TasS-RV/fpcb-glove-design/Forearm pad - proto cutout paper.jpg

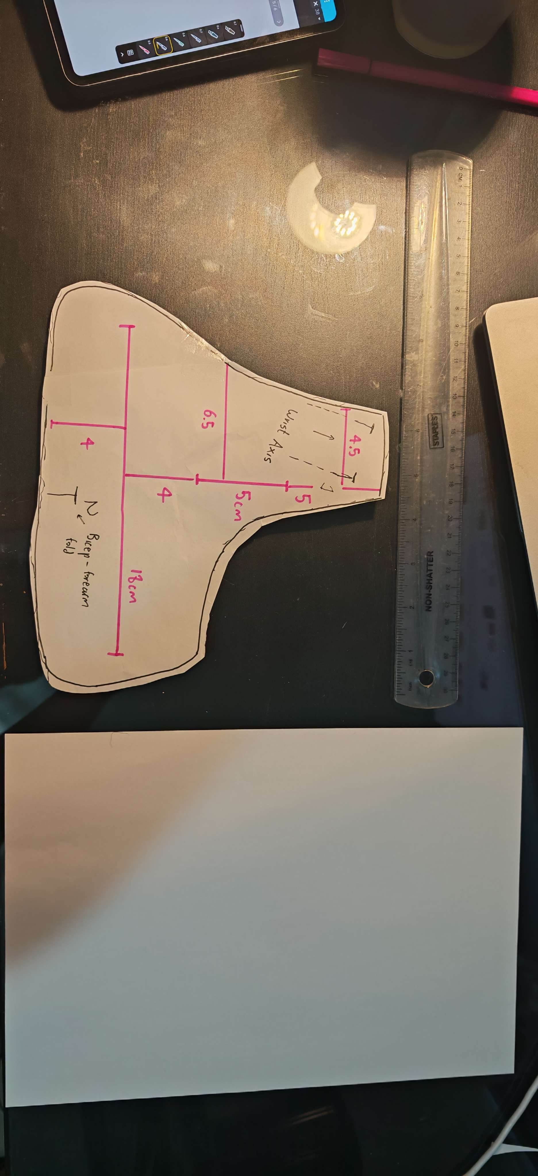
Forearm pad - proto cutout paper.jpg
