TasS-RV/fpcb-glove-design/forearm paper.jpg

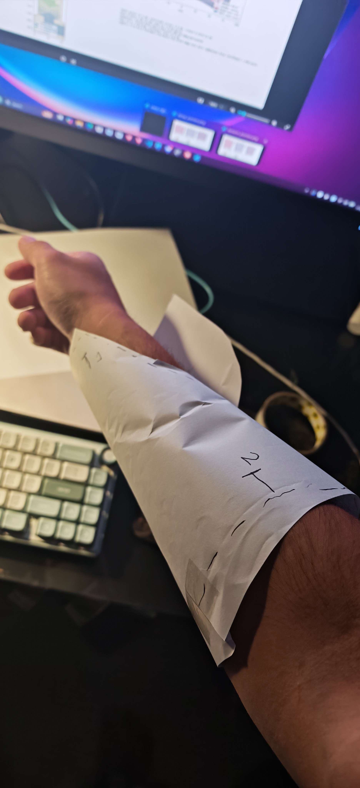
forearm paper.jpg
