TasS-RV/fpcb-glove-design/body_pads/out/bicep/pinout_Back.csv

J1 pin | channel | electrode_index | electrode_pos_mm | lane | via_row
5 | ROW01 | 1 | -60.30 | 11 | B
6 | ROW02 | 2 | -47.80 | 10 | A
7 | ROW03 | 3 | -35.30 | 9 | B
8 | ROW04 | 4 | -22.80 | 8 | A
9 | ROW05 | 5 | -10.30 | 7 | B
10 | ROW06 | 6 | 2.20 | 6 | A
11 | ROW07 | 7 | 14.70 | 5 | B
12 | ROW08 | 8 | 27.20 | 4 | A
13 | ROW09 | 9 | 39.70 | 3 | B
14 | ROW10 | 10 | 52.20 | 2 | A
15 | ROW11 | 11 | 64.70 | 1 | B
16 | ROW12 | 12 | 77.20 | 0 | A
1 | NC
2 | NC
3 | NC
4 | NC
