TasS-RV/fpcb-glove-design/body_pads/out/forearm/pinout_Back.csv

J1 pin | channel | electrode_index | electrode_pos_mm | lane | via_row
3 | ROW00 | 0 | -192.73 | 13 | B
4 | ROW01 | 1 | -179.23 | 12 | A
5 | ROW02 | 2 | -165.73 | 11 | B
6 | ROW03 | 3 | -152.23 | 10 | A
7 | ROW04 | 4 | -138.73 | 9 | B
8 | ROW05 | 5 | -125.23 | 8 | A
9 | ROW06 | 6 | -111.73 | 7 | B
10 | ROW07 | 7 | -98.23 | 6 | A
11 | ROW08 | 8 | -84.73 | 5 | B
12 | ROW09 | 9 | -71.23 | 4 | A
13 | ROW10 | 10 | -57.73 | 3 | B
14 | ROW11 | 11 | -44.23 | 2 | A
15 | ROW12 | 12 | -30.73 | 1 | B
16 | ROW13 | 13 | -17.23 | 0 | A
1 | NC
2 | NC
