TasS-RV/fpcb-glove-design/body_pads/out/forearm/pinout_Front.csv

J1 pin | channel | electrode_index | electrode_pos_mm | lane | via_row
1 | COL00 | 0 | -98.25 | 6 | A
2 | COL01 | 1 | -84.75 | 5 | B
3 | COL02 | 2 | -71.25 | 4 | A
4 | COL03 | 3 | -57.75 | 3 | B
5 | COL04 | 4 | -44.25 | 2 | A
6 | COL05 | 5 | -30.75 | 1 | B
7 | COL06 | 6 | -17.25 | 0 | A
8 | COL07 | 7 | -3.75 | 0 | B
9 | COL08 | 8 | 9.75 | 1 | A
10 | COL09 | 9 | 23.25 | 2 | B
11 | COL10 | 10 | 36.75 | 3 | A
12 | COL11 | 11 | 50.25 | 4 | B
13 | COL12 | 12 | 63.75 | 5 | A
14 | COL13 | 13 | 77.25 | 6 | B
15 | COL14 | 14 | 90.75 | 7 | A
16 | COL15 | 15 | 104.25 | 8 | B
