TasS-RV/fpcb-glove-design/body_pads/out/bicep/pinout_Front.csv

J1 pin | channel | electrode_index | electrode_pos_mm | lane | via_row
1 | COL00 | 0 | -79.25 | 5 | A
2 | COL01 | 1 | -66.75 | 4 | B
3 | COL02 | 2 | -54.25 | 3 | A
4 | COL03 | 3 | -41.75 | 2 | B
5 | COL04 | 4 | -29.25 | 1 | A
6 | COL05 | 5 | -16.75 | 0 | B
7 | COL06 | 6 | -4.25 | 0 | A
8 | COL07 | 7 | 8.25 | 1 | B
9 | COL08 | 8 | 20.75 | 2 | A
10 | COL09 | 9 | 33.25 | 3 | B
11 | COL10 | 10 | 45.75 | 4 | A
12 | COL11 | 11 | 58.25 | 5 | B
13 | COL12 | 12 | 70.75 | 6 | A
14 | COL13 | 13 | 83.25 | 7 | B
15 | NC
16 | NC
