TasS-RV/fpcb-glove-design/body_pads/out/chest_left/pinout_Front.csv

J1 pin | channel | electrode_index | electrode_pos_mm | lane | via_row
1 | COL00 | 0 | -156.50 | 1 | A
2 | COL01 | 1 | -144.50 | 0 | B
3 | COL02 | 2 | -132.50 | 0 | A
4 | COL03 | 3 | -120.50 | 1 | B
5 | COL04 | 4 | -108.50 | 2 | A
6 | COL05 | 5 | -96.50 | 3 | B
7 | COL06 | 6 | -84.50 | 4 | A
8 | COL07 | 7 | -72.50 | 5 | B
9 | COL08 | 8 | -60.50 | 6 | A
10 | COL09 | 9 | -48.50 | 7 | B
11 | COL10 | 10 | -36.50 | 8 | A
12 | COL11 | 11 | -24.50 | 9 | B
13 | NC
14 | NC
15 | NC
16 | NC
