TasS-RV/fpcb-glove-design/body_pads/out/chest_right/pinout_Back.csv

J1 pin | channel | electrode_index | electrode_pos_mm | lane | via_row
3 | ROW00 | 0 | -78.58 | 13 | B
4 | ROW01 | 1 | -66.58 | 12 | A
5 | ROW02 | 2 | -54.58 | 11 | B
6 | ROW03 | 3 | -42.58 | 10 | A
7 | ROW04 | 4 | -30.58 | 9 | B
8 | ROW05 | 5 | -18.58 | 8 | A
9 | ROW06 | 6 | -6.58 | 7 | B
10 | ROW07 | 7 | 5.42 | 6 | A
11 | ROW08 | 8 | 17.42 | 5 | B
12 | ROW09 | 9 | 29.42 | 4 | A
13 | ROW10 | 10 | 41.42 | 3 | B
14 | ROW11 | 11 | 53.42 | 2 | A
15 | ROW12 | 12 | 65.42 | 1 | B
16 | ROW13 | 13 | 77.42 | 0 | A
1 | NC
2 | NC
