TasS-RV/fpcb-glove-design/body_pads/out/bicep/bicep_tail.png

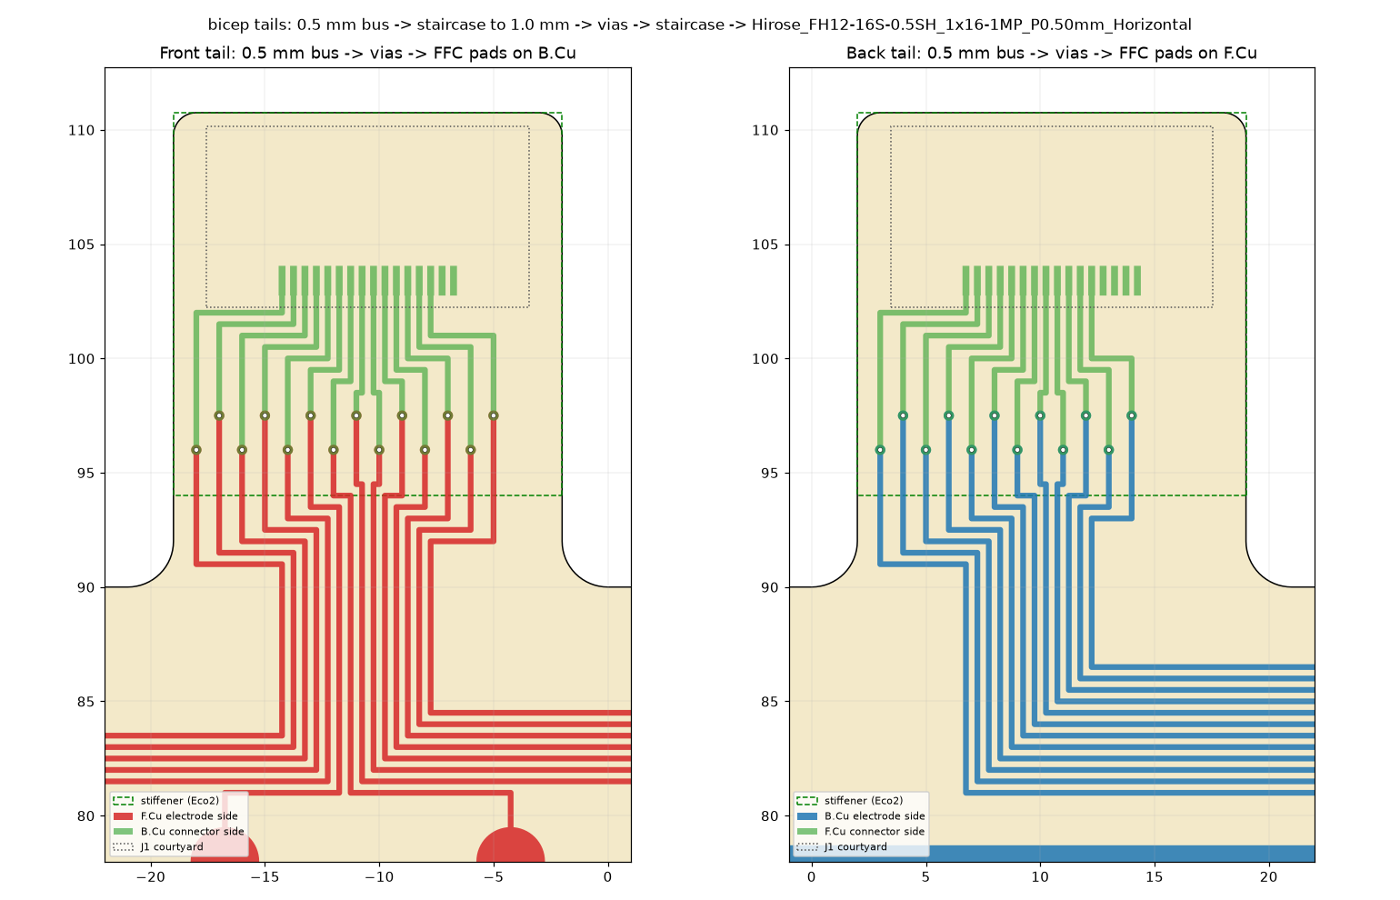
body_pads/out/bicep/bicep_tail.png
