TasS-RV/fpcb-glove-design/body_pads/out/chest_left/chest_left_preview.png

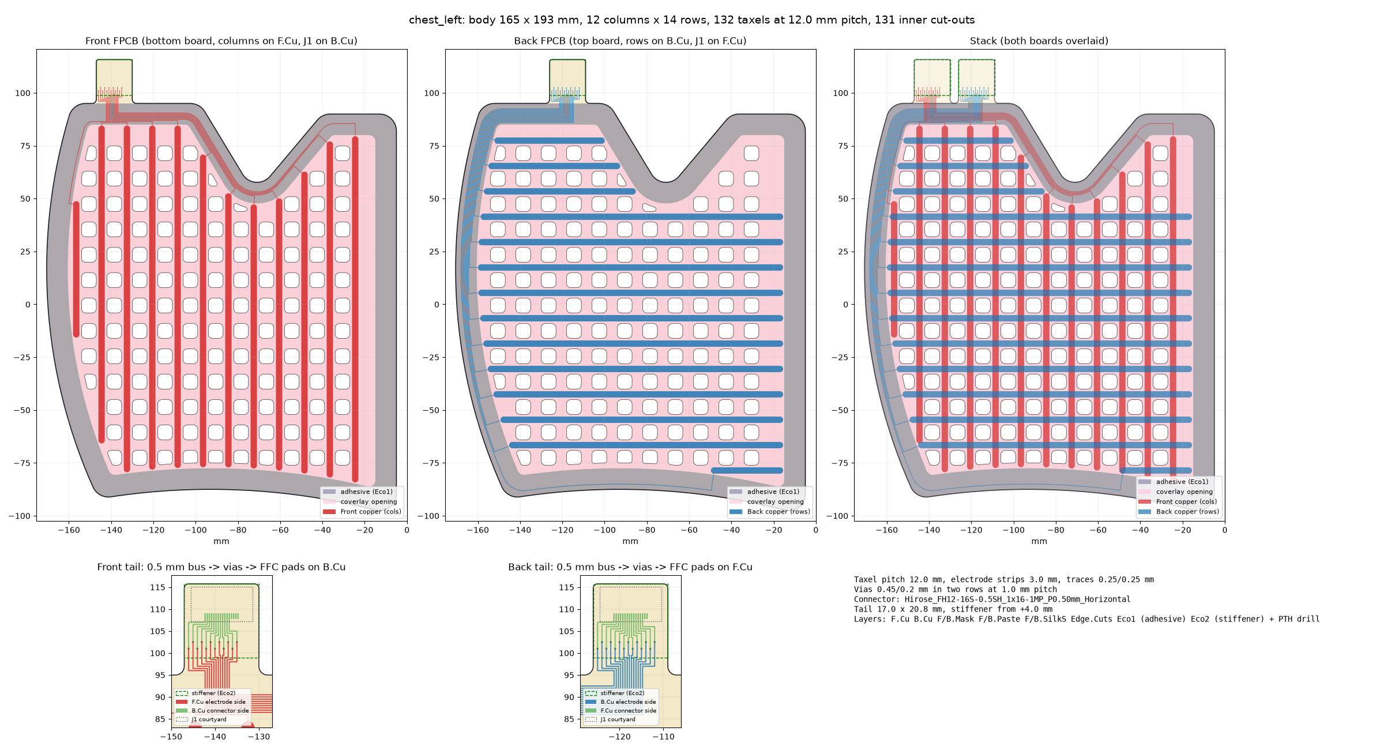
body_pads/out/chest_left/chest_left_preview.png
