TasS-RV/fpcb-glove-design/body_pads/out/forearm/forearm_preview.png

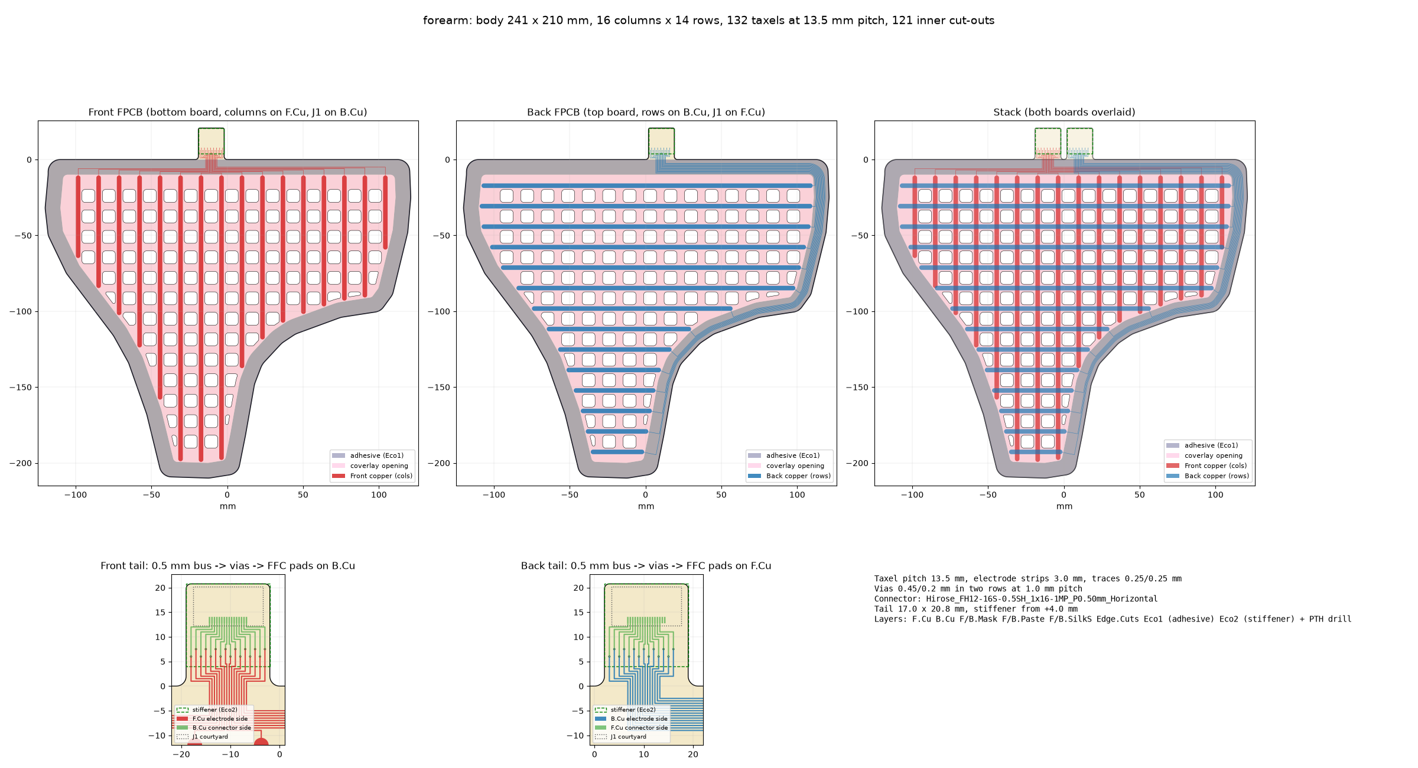
body_pads/out/forearm/forearm_preview.png
