TasS-RV/fpcb-glove-design/(commit log)

2026-10-17 Add forearm, bicep and chest body pad generator with KiCad/Gerber outputs
    body_pads/make_body_pads.py builds three tactile pad designs on the glove
    pipeline's construction (two single-sided FPCBs with orthogonal electrodes,
    coverlay opening, adhesive ring, offset-contour trace routing, inner
    cut-outs, <=16x16 electrodes) from parametric outlines: a forearm underside
    wrap, a bicep wrap and mirrored chest halves. Per pad it writes layered SVGs
    in the notebook's convention, svg2mod footprints, .kicad_pcb boards,
    kicad-cli Gerbers, pinouts, a laser-cut template and preview renders, and
    checks copper clearances. README documents the pads and ordering notes.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
    [bicep_Back-B_Cu.gbl, bicep_Back-B_Mask.gbs, bicep_Back-Edge_Cuts.gm1, bicep_Back-User_Comments.gbr, bicep_Back-User_Eco1.gbr, bicep_Back-User_Eco2.gbr, bicep_Back-job.gbrjob, bicep_Back.drl]
2026-10-17 Terminate body pads with vias and an FFC connector; export the full Gerber set
    The pad tails now follow README Step 5 like the glove: every electrode trace
    ends in a through via (0.45/0.2 mm, two staggered rows) and a 16-pin 0.5 mm
    FFC connector (KiCad library Hirose FH12-16S-0.5SH) sits on the side opposite
    the electrodes, making each board a 2-layer flex. A nested staircase fans the
    0.5 mm bus out to the 1.0 mm via pitch and back to the 0.5 mm pads without
    crossings. body_pads/kicad_post.py runs with KiCad's own python to add the
    vias, footprint, connector-side tracks and nets; a .kicad_pro with flex rules
    is written so kicad-cli DRC checks the right limits, and the Gerber export now
    produ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
    [bicep_Back-B_Cu.gbl, bicep_Back-B_Cu.gbr, bicep_Back-B_Mask.gbr, bicep_Back-B_Mask.gbs, bicep_Back-B_Paste.gbr, bicep_Back-B_Silkscreen.gbr, bicep_Back-Edge_Cuts.gbr, bicep_Back-Edge_Cuts.gm1]
2026-10-17 Iteratioin 1 of the forearm, bicep and chest pad Flex PCBs
2026-10-17 Iteration 2: forearm pad from the measured paper template, bicep rescaled
    The forearm outline is now digitised from the paper template wrapped round
    the wearer's forearm (FOREARM_TEMPLATE_MM, scaled by the ruler in the photo):
    240 mm round the arm at the elbow end, 210 mm long, narrowing to the 50 mm
    underside strap at the wrist, tails on the elbow-end edge. The bicep pad is
    scaled to the same arm (180 mm long, 200 -> 175 mm wide); the chest halves
    are unchanged. Boards carry "iter2" in their title block and summary.json,
    and all Gerbers, footprints, previews and checks are regenerated.
    Also adds the template photos and the updated documentation docx.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
    [bicep_Back-B_Cu.gbr, bicep_Back-B_Mask.gbr, bicep_Back-B_Paste.gbr, bicep_Back-B_Silkscreen.gbr, bicep_Back-Edge_Cuts.gbr, bicep_Back-F_Cu.gbr, bicep_Back-F_Mask.gbr, bicep_Back-F_Paste.gbr]
